cosmopotamian/HadesFCS/Hardware/Hades/Hades.kicad_pcb

## KiCad design Hardware/Hades/Hades.kicad_pcb (2025-03-08)

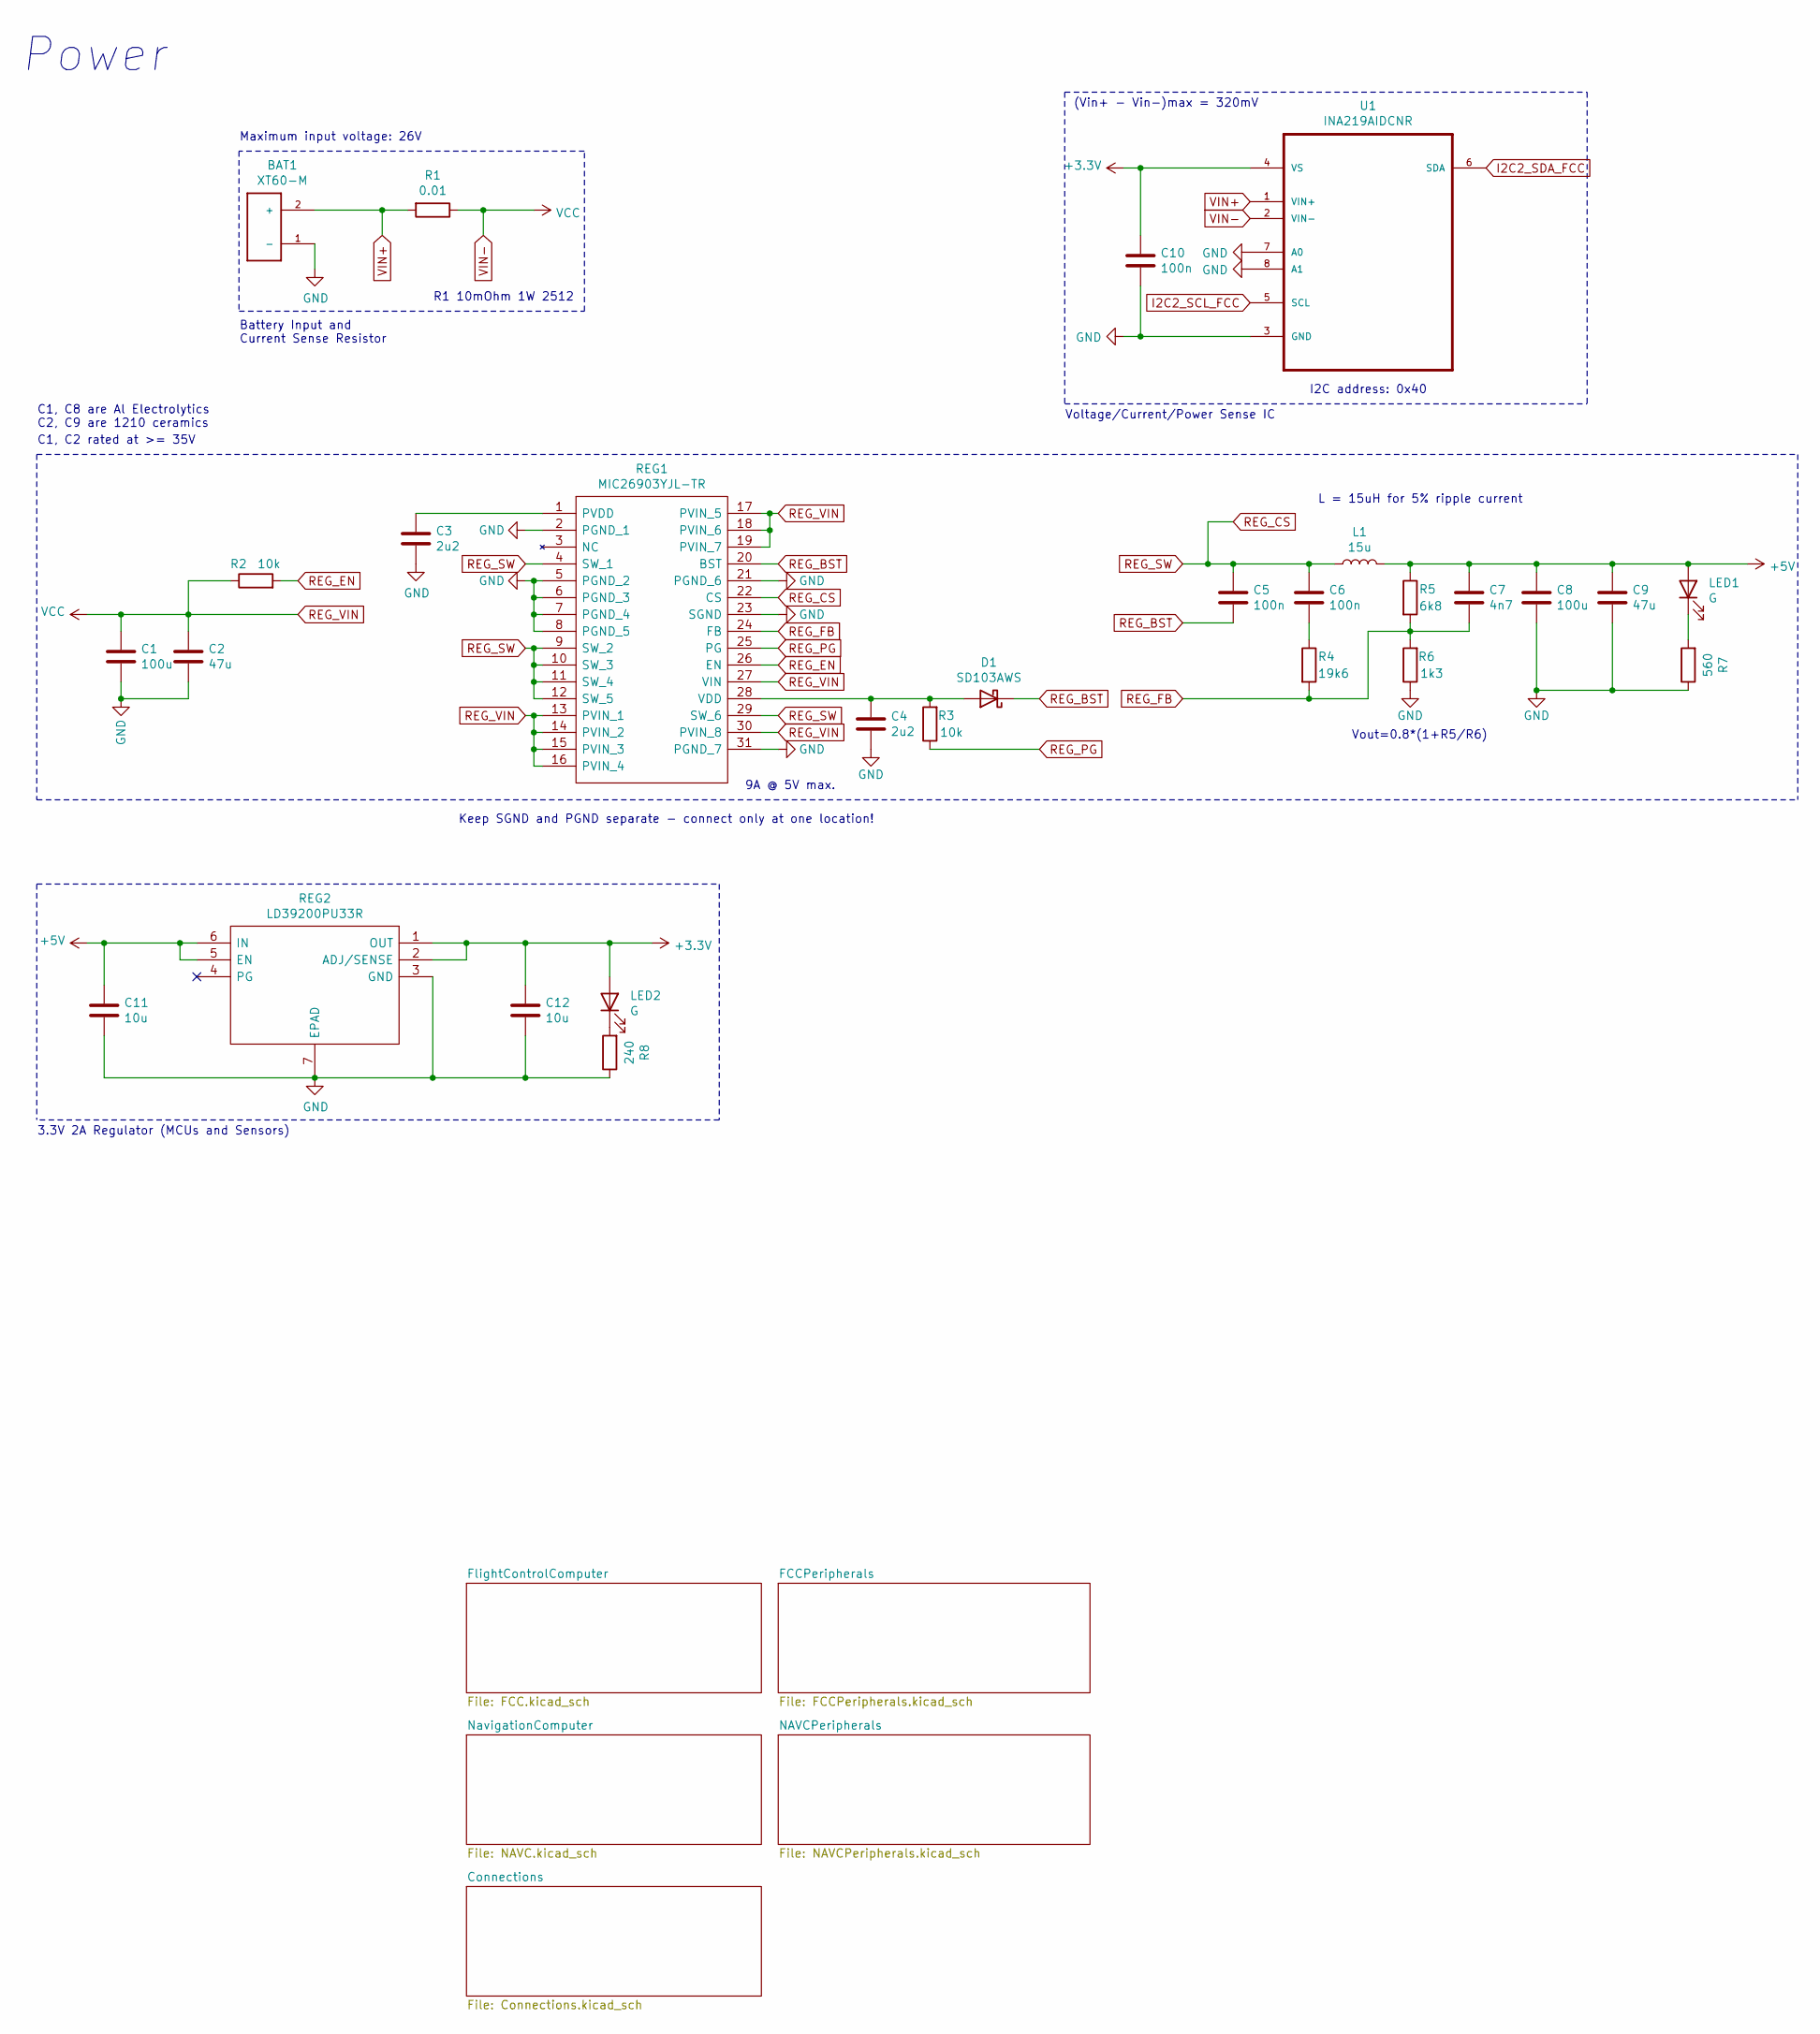
[picture p1: schematic Hades.kicad_sch, Power]

Parts:
BAT1: XT60-M; AMASS_XT60-M
C1, C8: 100u; C_Elec_6.3x7.7
C2, C9: 47u; C_1210_3225Metric
C3, C4: 2u2; C_0805_2012Metric
C5, C6: 100n; C_0805_2012Metric
C7: 4n7; C_0805_2012Metric
C10: 100n; C_0402_1005Metric
C11, C12: 10u; C_0603_1608Metric
D1: SD103AWS; D_SOD-323
L1: 15u; INDPM135125X650N
LED1, LED2: G; LED_0603_1608Metric
R1: 0.01; R_2512_6332Metric
R2, R3: 10k; R_0805_2012Metric
R4: 19k6; R_0805_2012Metric
R5: 6k8; R_0805_2012Metric
R6: 1k3; R_0805_2012Metric
R7: 560; R_0603_1608Metric
R8: 240; R_0603_1608Metric
REG1: MIC26903YJL-TR; MIC24054YJLTR; Manufacturer_Part_Number MIC26903YJL-TR; Mouser Part Number 998-MIC26903YJLTR
REG2: LD39200PU33R; SON95P300X300X100-7N-D; Manufacturer_Part_Number LD39200PU33R; Mouser Part Number 511-LD39200PU33R
U1: INA219AIDCNR; SOT65P280X145-8N

Connections:
+5V: C7.1, C8.1, C9.1, C11.1, L1.2, LED1.2 (A), R5.1, REG2.5 (EN), REG2.6 (IN); also elsewhere on the board
GND: BAT1.1 (-), C1.2, C2.2, C3.2, C4.2, C8.2, C9.2, C10.2, C11.2, C12.2, R6.1, R7.1, R8.1, REG1.2 (PGND_1), REG1.5 (PGND_2), REG1.6 (PGND_3), REG1.7 (PGND_4), REG1.8 (PGND_5), REG1.21 (PGND_6), REG1.23 (SGND), REG1.31 (PGND_7), REG2.3 (GND), REG2.7 (EPAD), U1.3 (GND), U1.7 (A0), U1.8 (A1); also elsewhere on the board
I2C2_SCL_FCC: U1.5 (SCL); also elsewhere on the board
I2C2_SDA_FCC: U1.6 (SDA); also elsewhere on the board
unnamed: C3.1, REG1.1 (PVDD)
unnamed: C4.1, D1.2 (A), R3.2, REG1.28 (VDD)
unnamed: C6.2, R4.1
unnamed: LED1.1 (K), R7.2
unnamed: LED2.1 (K), R8.2
REG_BST: C5.2, D1.1 (K), REG1.20 (BST)
REG_CS: C5.1, C6.1, L1.1, REG1.4 (SW_1), REG1.9 (SW_2), REG1.10 (SW_3), REG1.11 (SW_4), REG1.12 (SW_5), REG1.22 (CS), REG1.29 (SW_6)
REG_EN: R2.2, REG1.26 (EN)
REG_FB: C7.2, R4.2, R5.2, R6.2, REG1.24 (FB)
REG_PG: R3.1, REG1.25 (PG)
REG_VIN: C1.1, C2.1, R1.1, R2.1, REG1.13 (PVIN_1), REG1.14 (PVIN_2), REG1.15 (PVIN_3), REG1.16 (PVIN_4), REG1.17 (PVIN_5), REG1.18 (PVIN_6), REG1.19 (PVIN_7), REG1.27 (VIN), REG1.30 (PVIN_8), U1.2 (VIN-)
VIN+: BAT1.2 (+), R1.2, U1.1 (VIN+)

Notes on the sheet:
Voltage/Current/Power Sense IC
Power
C1, C8 are Al Electrolytics C2, C9 are 1210 ceramics
C1, C2 rated at >= 35V
(Vin+ - Vin-)max = 320mV
R1 10mOhm 1W 2512
3.3V 2A Regulator (MCUs and Sensors)
9A @ 5V max.
Vout=0.8*(1+R5/R6)
L = 15uH for 5% ripple current
Keep SGND and PGND separate - connect only at one location!
I2C address: 0x40
Maximum input voltage: 26V
Battery Input and Current Sense Resistor

Schematic: FCC.kicad_sch, Flight Control Computer

Parts:
C13, C14: 2u2; C_0603_1608Metric
C15: 10u; C_0603_1608Metric
C16, C17, C18, C19, C20, C21, C22, C23, C24, C25, C26, C28, C30, C31: 100n; C_0402_1005Metric
C27, C29: 1u; C_0603_1608Metric
C32, C33: 10p; C_0402_1005Metric
FB1: Ferrite_Bead_Small; L_0402_1005Metric
FCC1: STM32H753VITx; LQFP-100_14x14mm_P0.5mm
HSE1: 25MHz; Crystal_SMD_Abracon_ABM8G-4Pin_3.2x2.5mm
LED3, LED4: R; LED_0603_1608Metric
LED5: Y; LED_0603_1608Metric
LED6, LED7, LED8: B; LED_0603_1608Metric
R9, R10, R11, R12, R13, R14: 4k7; R_0402_1005Metric
R15, R16, R17: 330; R_0603_1608Metric
R18, R19, R20: 100; R_0603_1608Metric
R21: 47; R_0402_1005Metric
R22: 10k; R_0402_1005Metric
R23: 620; R_0603_1608Metric
SW1: SKRPANE010; SKRPADE010; Manufacturer_Part_Number SKRPANE010; Mouser Part Number 688-SKRPANE010
SW2: TDD01H0SB1R; SOT175P420X230-3N; Manufacturer_Part_Number TDD01H0SB1R; Mouser Part Number 611-TDD01H0SB1R
TP1, TP2: I2C1; TestPoint_Pad_D1.5mm

Connections:
BOOT0_FCC: R22.2; also elsewhere on the board
GND: C13.2, C14.2, C15.2, C16.2, C17.2, C18.2, C19.2, C20.2, C21.2, C22.2, C23.2, C24.2, C25.2, C26.2, C27.2, C28.2, C29.2, C30.2, C31.2, C32.2, C33.2, FCC1.10 (VSS), FCC1.19 (VSSA), FCC1.26 (VSS), FCC1.49 (VSS), FCC1.74 (VSS), FCC1.99 (VSS), HSE1.2, HSE1.4, R15.1, R16.1, R17.1, R18.1, R19.1, R20.1, SW1.3, SW1.4, SW2.2; also elsewhere on the board
HSE_IN_FCC: C32.1, FCC1.5 (PE6), HSE1.1; also elsewhere on the board
HSE_OUT_FCC: FCC1.37 (PE7), R23.1; also elsewhere on the board
I2C1_SCL_FCC: FCC1.93 (PB7), R9.2, TP1.1; also elsewhere on the board
I2C1_SDA_FCC: FCC1.95 (PB8), R10.2, TP2.1; also elsewhere on the board
I2C2_SCL_FCC: FCC1.47 (PB11), R11.2; also elsewhere on the board
I2C2_SDA_FCC: FCC1.51 (PB12), R12.2; also elsewhere on the board
I2C3_SCL_FCC: FCC1.68 (PA9), R13.2; also elsewhere on the board
I2C3_SDA_FCC: FCC1.78 (PC10), R14.2; also elsewhere on the board
LED_A_FCC: FCC1.35 (PB1), LED3.2 (A); also elsewhere on the board
LED_B_FCC: FCC1.36 (PB2), LED4.2 (A); also elsewhere on the board
LED_C_FCC: FCC1.89 (PB3), LED5.2 (A); also elsewhere on the board
LED_D_FCC: FCC1.90 (PB4), LED6.2 (A); also elsewhere on the board
LED_E_FCC: FCC1.91 (PB5), LED7.2 (A); also elsewhere on the board
LED_F_FCC: FCC1.92 (PB6), LED8.2 (A); also elsewhere on the board
NRST_FCC: C31.1, SW1.1, SW1.2; also elsewhere on the board
unnamed 65: C13.1; also elsewhere on the board
unnamed 66: C14.1, FCC1.12 (PH0); also elsewhere on the board
unnamed: C33.1, HSE1.3, R23.2
unnamed: LED3.1 (K), R15.2
unnamed: LED4.1 (K), R16.2
unnamed: LED5.1 (K), R17.2
unnamed: LED6.1 (K), R18.2
unnamed: LED7.1 (K), R19.2
unnamed: LED8.1 (K), R20.2
unnamed: R22.1, SW2.3 (C)
VDDA_FCC: C27.1, C28.1, FB1.1, R21.2; also elsewhere on the board
VREF+_FCC: C29.1, C30.1, FCC1.13 (PH1), R21.1; also elsewhere on the board

Notes on the sheet:
Bootmode Switch
C32 = C33 = 2 * (CL - Cstray)
Flight Control Computer (FCC)
High Speed External Crystal
C13, C14: ESR < 100mOhm
AN2606 (Bootloaders): USART1 Bootloader (PB14/PB15)
STM32H7: see AN4938
ABM8G-25.000MHZ-4Y-T3
Test Points (I2C2)
UART2, I2C1, and GPIO_A to GPIO_H -> NAVC UART1 -> Debug (via USB) TIM4 -> PWM/PPM input
Not using LSE as do not need RTC
C15, C27, C29 Tantalum
Rext = 1/(2*pi*f*CL2)
TDD01H0SB1R = SPDT
VREF+ Filter
VDDA Filter
Reset Switch
Indicator LEDs
Decoupling Capactors
STM32H7 has internal NRST pull-up resistor (40k)
I2C Pull-Up Resistors
Cstray = {2pF, 5pf}

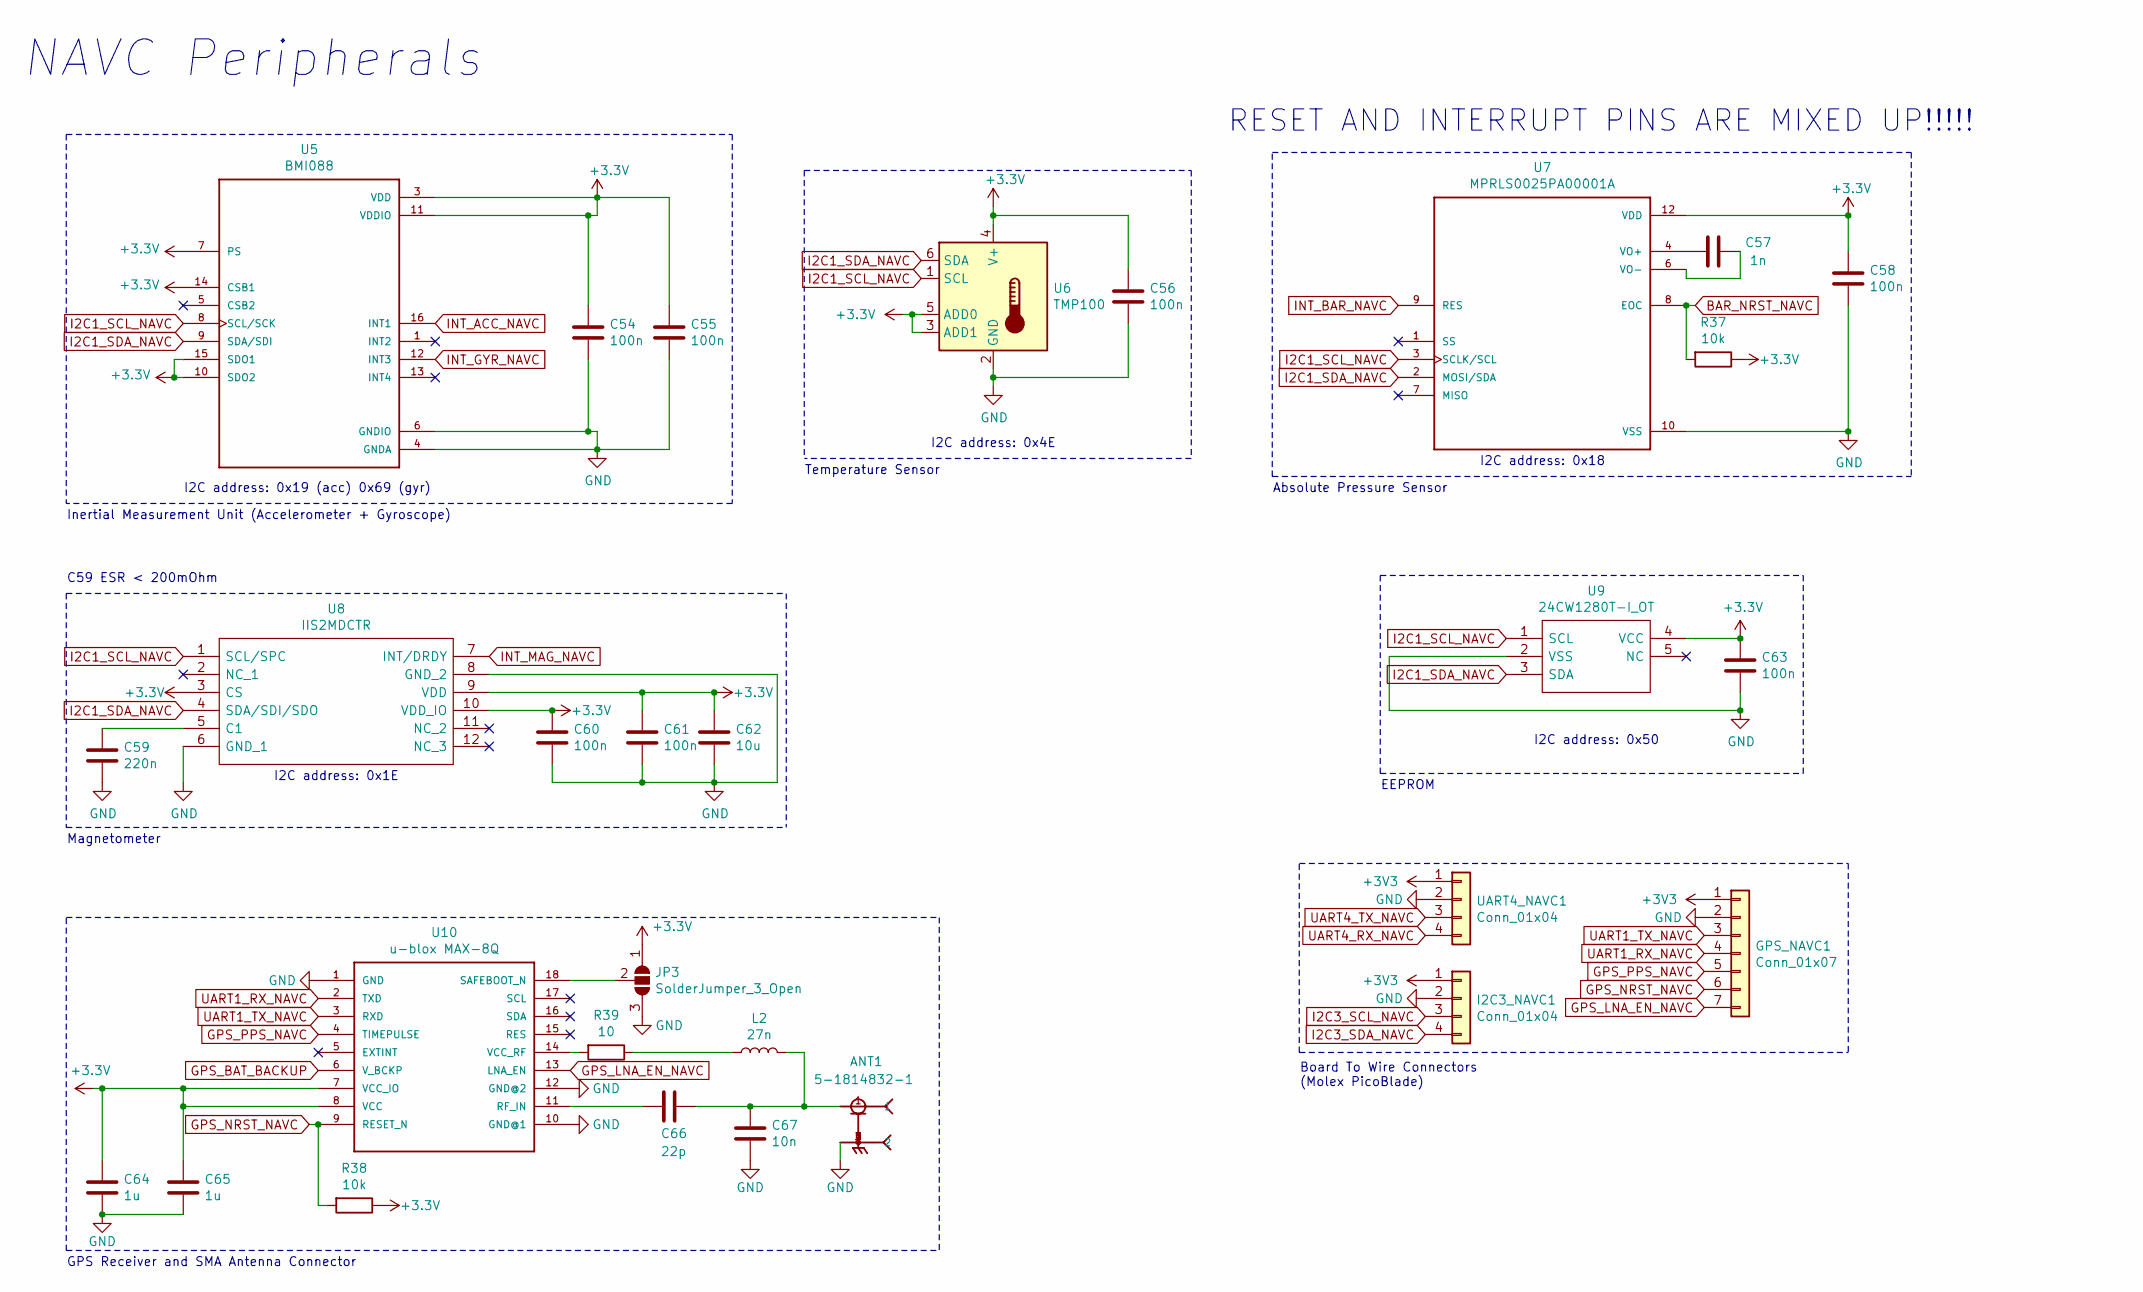
[picture p2: schematic NAVCPeripherals.kicad_sch, NAVC Peripherals]

Parts:
ANT1: 5-1814832-1; TE_5-1814832-1
C54, C55, C56, C58, C60, C61, C63: 100n; C_0402_1005Metric
C57: 1n; C_0402_1005Metric
C59: 220n; C_0603_1608Metric
C62: 10u; C_0603_1608Metric
C64, C65: 1u; C_0603_1608Metric
C66: 22p; C_0402_1005Metric
C67: 10n; C_0402_1005Metric
GPS_NAVC1: Conn_01x07; Molex_PicoBlade_53048-0710_1x07_P1.25mm_Horizontal
I2C3_NAVC1: Conn_01x04; Molex_PicoBlade_53048-0410_1x04_P1.25mm_Horizontal
JP3: SolderJumper_3_Open; SolderJumper-3_P1.3mm_Open_RoundedPad1.0x1.5mm
L2: 27n; L_0402_1005Metric
R37, R38: 10k; R_0402_1005Metric
R39: 10; R_0402_1005Metric
U5: BMI088; PQFN50P450X300X100-16N
U6: TMP100; SOT-23-6
U7: MPRLS0025PA00001A; XDCR_MPRLS0025PA00001A
U8: IIS2MDCTR; Manufacturer_Part_Number IIS2MDCTR; Mouser Part Number 511-IIS2MDCTR
U9: 24CW1280T-I_OT; SOT95P280X145-5N; Manufacturer_Part_Number 24CW1280T-I/OT; Mouser Part Number 579-24CW1280T-I/OT
U10: u-blox MAX-8Q; GPS18P-SMD-1.1-10X9.6MM
UART4_NAVC1: Conn_01x04; Molex_PicoBlade_53048-0410_1x04_P1.25mm_Horizontal

Connections:
BAR_NRST_NAVC: R37.2, U7.8 (EOC); also elsewhere on the board
GND: ANT1.2, ANT1.3 (2), ANT1.4 (2), ANT1.5 (2), C54.2, C55.2, C56.2, C58.2, C59.2, C60.2, C61.2, C62.2, C63.2, C64.2, C65.2, C67.2, GPS_NAVC1.2, I2C3_NAVC1.2, JP3.3 (B), U5.4 (GNDA), U5.6 (GNDIO), U6.2 (GND), U7.10 (VSS), U8.6 (GND_1), U8.8 (GND_2), U9.2 (VSS), U10.1 (GND), U10.10 (GND@1), U10.12 (GND@2), UART4_NAVC1.2; also elsewhere on the board
GPS_BAT_BACKUP: U10.6 (V_BCKP); also elsewhere on the board
GPS_LNA_EN_NAVC: GPS_NAVC1.7, U10.13 (LNA_EN); also elsewhere on the board
GPS_NRST_NAVC: GPS_NAVC1.6, R38.2, U10.9 (RESET_N); also elsewhere on the board
GPS_PPS_NAVC: GPS_NAVC1.5, U10.4 (TIMEPULSE); also elsewhere on the board
I2C1_SCL_NAVC: U5.8 (SCL/SCK), U6.1 (SCL), U7.3 (SCLK/SCL), U8.1 (SCL/SPC), U9.1 (SCL); also elsewhere on the board
I2C1_SDA_NAVC: U5.9 (SDA/SDI), U6.6 (SDA), U7.2 (MOSI/SDA), U8.4 (SDA/SDI/SDO), U9.3 (SDA); also elsewhere on the board
INT_ACC_NAVC: U5.16 (INT1); also elsewhere on the board
INT_BAR_NAVC: U7.9 (RES); also elsewhere on the board
INT_GYR_NAVC: U5.12 (INT3); also elsewhere on the board
INT_MAG_NAVC: U8.7 (INT/DRDY); also elsewhere on the board
unnamed: ANT1.1, C66.1, C67.1, L2.2
unnamed: C57.1, U7.6 (VO-)
unnamed: C57.2, U7.4 (VO+)
unnamed: C59.1, U8.5 (C1)
unnamed: C66.2, U10.11 (RF_IN)
unnamed: GPS_NAVC1.1, I2C3_NAVC1.1, UART4_NAVC1.1
unnamed: JP3.2 (C), U10.18 (SAFEBOOT_N)
unnamed: L2.1, R39.1
unnamed: R39.2, U10.14 (VCC_RF)
UART1_RX_NAVC: GPS_NAVC1.4, U10.2 (TXD); also elsewhere on the board
UART1_TX_NAVC: GPS_NAVC1.3, U10.3 (RXD); also elsewhere on the board

Notes on the sheet:
Board To Wire Connectors (Molex PicoBlade)
Inertial Measurement Unit (Accelerometer + Gyroscope)
C59 ESR < 200mOhm
I2C address: 0x1E
NAVC Peripherals
I2C address: 0x18
EEPROM
Temperature Sensor
I2C address: 0x19 (acc) 0x69 (gyr)
GPS Receiver and SMA Antenna Connector
I2C address: 0x4E
RESET AND INTERRUPT PINS ARE MIXED UP!!!!!
Magnetometer
Absolute Pressure Sensor
I2C address: 0x50

Schematic: Connections.kicad_sch

Parts:
C68, C69, C70, C71: 100n; C_0402_1005Metric
D2, D3, D4, D5: SD103AWS; D_SOD-323
FB3, FB4, FB5, FB6: Ferrite_Bead_Small; L_0402_1005Metric
GPS_BAT1: Conn_01x02; Molex_PicoBlade_53048-0210_1x02_P1.25mm_Horizontal
JP1, JP2: SolderJumper_2_Open; SolderJumper-2_P1.3mm_Open_RoundedPad1.0x1.5mm
JP4: Jumper_3_Open; SolderJumper-3_P1.3mm_Open_RoundedPad1.0x1.5mm
LED13, LED14: G; LED_0603_1608Metric
R40, R41, R42, R43, R44, R45, R46, R47, R48, R49: 10; R_0402_1005Metric
R50, R51: 0; R_0603_1608Metric
R52, R53, R55, R56: 22; R_0402_1005Metric
R54, R57: 560; R_0402_1005Metric
R58, R59: 560; R_0603_1608Metric
SWD1, SWD2: Conn_02x05_Odd_Even; PinHeader_2x05_P1.27mm_Vertical_SMD
U11, U12: otter:CH330; SSOP-8_3.9x5.05mm_P1.27mm
USB1, USB2, USB3, USB4: USB_B_Micro; USB_Micro-B_Wuerth_629105150521_CircularHoles

Connections:
+5V: FB3.1, FB4.1, FB5.1, FB6.1; also elsewhere on the board
GND: C68.1, C69.1, C70.1, C71.1, GPS_BAT1.2, R58.1, R59.1, SWD1.3, SWD1.5, SWD1.9, SWD2.3, SWD2.5, SWD2.9, U11.3, U12.3, USB1.5 (GND), USB1.6 (Shield), USB2.5 (GND), USB2.6 (Shield), USB3.5 (GND), USB3.6 (Shield), USB4.5 (GND), USB4.6 (Shield); also elsewhere on the board
GPIO_A_FCC: R40.2; also elsewhere on the board
GPIO_A_NAVC: R40.1; also elsewhere on the board
GPIO_B_FCC: R41.2; also elsewhere on the board
GPIO_B_NAVC: R41.1; also elsewhere on the board
GPIO_C_FCC: R42.2; also elsewhere on the board
GPIO_C_NAVC: R42.1; also elsewhere on the board
GPIO_D_FCC: R43.2; also elsewhere on the board
GPIO_D_NAVC: R43.1; also elsewhere on the board
GPIO_E_FCC: R44.2; also elsewhere on the board
GPIO_E_NAVC: R44.1; also elsewhere on the board
GPIO_F_FCC: R45.2; also elsewhere on the board
GPIO_F_NAVC: R45.1; also elsewhere on the board
GPIO_G_FCC: R46.2; also elsewhere on the board
GPIO_G_NAVC: R46.1; also elsewhere on the board
GPIO_H_FCC: R47.2; also elsewhere on the board
GPIO_H_NAVC: R47.1; also elsewhere on the board
GPS_BAT_BACKUP: JP4.2 (C); also elsewhere on the board
I2C1_SCL_FCC: R50.2; also elsewhere on the board
I2C1_SDA_FCC: R51.2; also elsewhere on the board
I2C2_SCL_NAVC: R50.1; also elsewhere on the board
I2C2_SDA_NAVC: R51.1; also elsewhere on the board
unnamed: C68.2, D4.2 (A), LED13.2 (A), U11.5, USB3.1 (VBUS)
unnamed: C69.2, U11.8
unnamed: C70.2, D5.2 (A), LED14.2 (A), U12.5, USB4.1 (VBUS)
unnamed: C71.2, U12.8
unnamed: D2.1 (K), FB3.2
unnamed: D2.2 (A), JP1.1 (A), USB1.1 (VBUS)
unnamed: D3.1 (K), FB4.2
unnamed: D3.2 (A), JP2.1 (A), USB2.1 (VBUS)
unnamed: D4.1 (K), FB5.2
unnamed: D5.1 (K), FB6.2
unnamed 119: GPS_BAT1.1, JP4.3 (B); also elsewhere on the board
unnamed: LED13.1 (K), R58.2
unnamed: LED14.1 (K), R59.2
unnamed: R52.2, USB1.3 (D+)
unnamed: R53.2, USB1.2 (D-)
unnamed: R54.2, USB1.4 (ID)
unnamed: R55.2, USB2.3 (D+)
unnamed: R56.2, USB2.2 (D-)
unnamed: R57.2, USB2.4 (ID)
unnamed: SWD1.1, SWD2.1
unnamed: U11.1, USB3.3 (D+)
unnamed: U11.2, USB3.2 (D-)
unnamed: U12.1, USB4.3 (D+)
unnamed: U12.2, USB4.2 (D-)
UART1_RX_FCC: U11.6; also elsewhere on the board
UART1_TX_FCC: U11.7; also elsewhere on the board
UART2_RX_FCC: R48.2; also elsewhere on the board
UART2_RX_NAVC: R49.1; also elsewhere on the board
UART2_TX_FCC: R49.2; also elsewhere on the board
UART2_TX_NAVC: R48.1; also elsewhere on the board
UART3_RX_NAVC: U12.6; also elsewhere on the board
UART3_TX_NAVC: U12.7; also elsewhere on the board
USB_DM_FCC: R53.1; also elsewhere on the board
USB_DM_NAVC: R56.1; also elsewhere on the board
USB_DP_FCC: R52.1; also elsewhere on the board
USB_DP_NAVC: R55.1; also elsewhere on the board
USB_ID_FCC: R54.1; also elsewhere on the board
USB_ID_NAVC: R57.1; also elsewhere on the board
USB_VBUS_FCC: JP1.2 (B); also elsewhere on the board
USB_VBUS_NAVC: JP2.2 (B); also elsewhere on the board

Notes on the sheet:
GPS Backup Battery Jumper and Connector
Serial Wire Debug
Connectors (Programming & Debug)
USB Debug
GPS Backup Battery
CH330 UART to USB Converters
USB Programming
GPIO Connections
UART Connections
I2C Connections
Connector: M50-3600542R
Connections (FCC <-> NAVC)

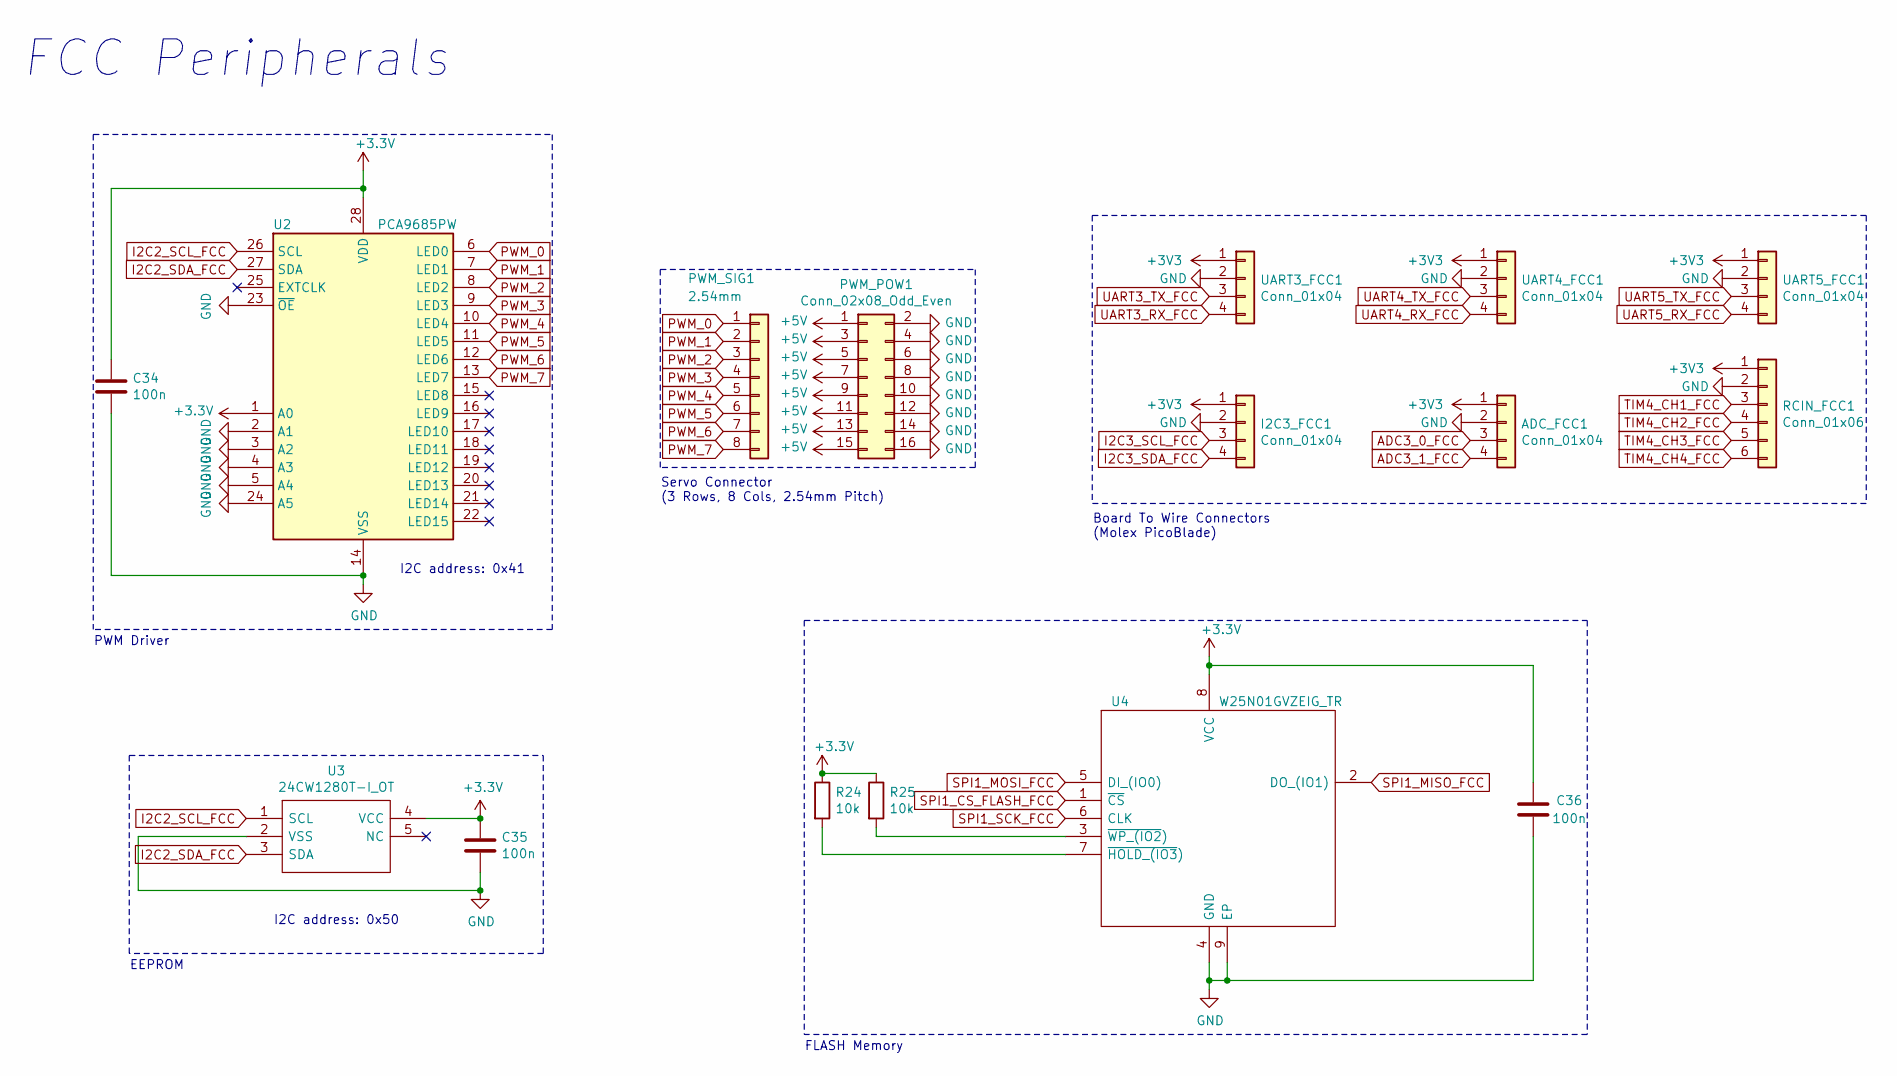
[picture p3: schematic FCCPeripherals.kicad_sch, FCC Peripherals]

Parts:
ADC_FCC1: Conn_01x04; Molex_PicoBlade_53048-0410_1x04_P1.25mm_Horizontal
C34, C35, C36: 100n; C_0402_1005Metric
I2C3_FCC1: Conn_01x04; Molex_PicoBlade_53048-0410_1x04_P1.25mm_Horizontal
PWM_POW1: Conn_02x08_Odd_Even; PinHeader_2x08_P2.54mm_Vertical
PWM_SIG1: 2.54mm; PinHeader_1x08_P2.54mm_Vertical
R24, R25: 10k; R_0402_1005Metric
RCIN_FCC1: Conn_01x06; Molex_PicoBlade_53048-0610_1x06_P1.25mm_Horizontal
U2: PCA9685PW; TSSOP-28_4.4x9.7mm_P0.65mm
U3: 24CW1280T-I_OT; SOT95P280X145-5N; Manufacturer_Part_Number 24CW1280T-I/OT; Mouser Part Number 579-24CW1280T-I/OT
U4: W25N01GVZEIG_TR; SON127P800X600X80-9N-D; Manufacturer_Part_Number W25N01GVZEIG TR; Mouser Part Number 454-W25N01GVZEIGTR
UART3_FCC1, UART4_FCC1, UART5_FCC1: Conn_01x04; Molex_PicoBlade_53048-0410_1x04_P1.25mm_Horizontal

Connections:
+5V: PWM_POW1.1, PWM_POW1.3, PWM_POW1.5, PWM_POW1.7, PWM_POW1.9, PWM_POW1.11, PWM_POW1.13, PWM_POW1.15; also elsewhere on the board
GND: ADC_FCC1.2, C34.2, C35.2, C36.1, I2C3_FCC1.2, PWM_POW1.2, PWM_POW1.4, PWM_POW1.6, PWM_POW1.8, PWM_POW1.10, PWM_POW1.12, PWM_POW1.14, PWM_POW1.16, RCIN_FCC1.2, U2.2 (A1), U2.3 (A2), U2.4 (A3), U2.5 (A4), U2.14 (VSS), U2.23 (~OE), U2.24 (A5), U3.2 (VSS), U4.4 (GND), U4.9 (EP), UART3_FCC1.2, UART4_FCC1.2, UART5_FCC1.2; also elsewhere on the board
I2C2_SCL_FCC: U2.26 (SCL), U3.1 (SCL); also elsewhere on the board
I2C2_SDA_FCC: U2.27 (SDA), U3.3 (SDA); also elsewhere on the board
unnamed: ADC_FCC1.1, I2C3_FCC1.1, RCIN_FCC1.1, UART3_FCC1.1, UART4_FCC1.1, UART5_FCC1.1
unnamed: R24.2, U4.7 (~HOLD_(IO3))
unnamed: R25.2, U4.3 (~WP_(IO2))
PWM_0: PWM_SIG1.1, U2.6 (LED0)
PWM_1: PWM_SIG1.2, U2.7 (LED1)
PWM_2: PWM_SIG1.3, U2.8 (LED2)
PWM_3: PWM_SIG1.4, U2.9 (LED3)
PWM_4: PWM_SIG1.5, U2.10 (LED4)
PWM_5: PWM_SIG1.6, U2.11 (LED5)
PWM_6: PWM_SIG1.7, U2.12 (LED6)
PWM_7: PWM_SIG1.8, U2.13 (LED7)
SPI1_CS_FLASH_FCC: U4.1 (~CS); also elsewhere on the board
SPI1_MISO_FCC: U4.2 (DO_(IO1)); also elsewhere on the board
SPI1_MOSI_FCC: U4.5 (DI_(IO0)); also elsewhere on the board
SPI1_SCK_FCC: U4.6 (CLK); also elsewhere on the board

Notes on the sheet:
I2C address: 0x41
EEPROM
FLASH Memory
Board To Wire Connectors (Molex PicoBlade)
Servo Connector (3 Rows, 8 Cols, 2.54mm Pitch)
PWM Driver
FCC Peripherals
I2C address: 0x50

Schematic: NAVC.kicad_sch, Navigation Computer

Parts:
C37, C38: 2u2; C_0603_1608Metric
C39: 10u; C_0603_1608Metric
C40, C41, C42, C43, C44, C45, C46, C47, C48, C49, C51: 100n; C_0402_1005Metric
C50: 1u; C_0603_1608Metric
C52, C53: 10p; C_0402_1005Metric
FB2: Ferrite_Bead_Small; L_0402_1005Metric
HSE2: 25MHz; Crystal_SMD_Abracon_ABM8G-4Pin_3.2x2.5mm
LED9, LED10: R; LED_0603_1608Metric
LED11: Y; LED_0603_1608Metric
LED12: B; LED_0603_1608Metric
NAVC1: STM32F405RGTx; LQFP-64_10x10mm_P0.5mm
R26, R27: 10k; R_0402_1005Metric
R28, R29, R30, R31: 4k7; R_0402_1005Metric
R32: 620; R_0603_1608Metric
R33, R34, R35: 330; R_0603_1608Metric
R36: 100; R_0603_1608Metric
SW3, SW4: TDD01H0SB1R; SOT175P420X230-3N; Manufacturer_Part_Number TDD01H0SB1R; Mouser Part Number 611-TDD01H0SB1R
SW5: SKRPANE010; SKRPADE010; Manufacturer_Part_Number SKRPANE010; Mouser Part Number 688-SKRPANE010
TP3, TP4: I2C1; TestPoint_Pad_D1.5mm

Connections:
BOOT0_NAVC: R26.2; also elsewhere on the board
BOOT1_NAVC: R27.2; also elsewhere on the board
GND: C37.2, C38.2, C39.2, C40.2, C41.2, C42.2, C43.2, C44.2, C45.2, C46.2, C47.2, C48.2, C49.2, C50.2, C51.2, C52.2, C53.2, HSE2.2, HSE2.4, R33.1, R34.1, R35.1, R36.1, SW3.2, SW4.2, SW5.3, SW5.4; also elsewhere on the board
HSE_IN_NAVC: C52.1, HSE2.1; also elsewhere on the board
HSE_OUT_NAVC: R32.1; also elsewhere on the board
I2C1_SCL_NAVC: R28.2, TP3.1; also elsewhere on the board
I2C1_SDA_NAVC: R29.2, TP4.1; also elsewhere on the board
I2C3_SCL_NAVC: R30.2; also elsewhere on the board
I2C3_SDA_NAVC: R31.2; also elsewhere on the board
LED_A_NAVC: LED9.2 (A); also elsewhere on the board
LED_B_NAVC: LED10.2 (A); also elsewhere on the board
LED_C_NAVC: LED11.2 (A); also elsewhere on the board
LED_D_NAVC: LED12.2 (A); also elsewhere on the board
NRST_NAVC: C49.1, SW5.1, SW5.2; also elsewhere on the board
unnamed 68: C37.1, NAVC1.5 (PH0); also elsewhere on the board
unnamed 69: C38.1, NAVC1.6 (PH1); also elsewhere on the board
unnamed: C53.1, HSE2.3, R32.2
unnamed: LED9.1 (K), R33.2
unnamed: LED10.1 (K), R34.2
unnamed: LED11.1 (K), R35.2
unnamed: LED12.1 (K), R36.2
unnamed: NAVC1.18 (VSS), NAVC1.63 (VSS)
unnamed: R26.1, SW3.3 (C)
unnamed: R27.1, SW4.3 (C)
VDDA_NAVC: C50.1, C51.1, FB2.1, NAVC1.13 (VDDA); also elsewhere on the board

Notes on the sheet:
Cstray = {2pF, 5pf}
UART2, I2C2, and GPIO_A to GPIO_H -> FCC UART3 -> Debug (via USB)
Indicator LEDs
I2C Pull-Up Resistors
C39, C50 Tantalum
Rext = 1/(2*pi*f*CL2)
C52 = C53 = 2 * (CL - Cstray)
ABM8G-25.000MHZ-4Y-T3
Reset Switch
High Speed External Crystal
Decoupling Capactors
Navigation Computer (NAVC)
VDDA Filter
C37, C38: ESR < 100mOhm
STM32F4 has internal NRST pull-up resistor (40k)
I2C2_NAVC already pulled up by I2C1_FCC resistors!
AN2606 (Bootloaders): USART3 Bootloader PC10/PC11
Test Points (I2C1)
Bootmode Switches

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
