cosmopotamian/HadesFCS/Hardware/Hades/Hades.kicad_pcb

## KiCad design Hardware/Hades/Hades.kicad_pcb (continued)

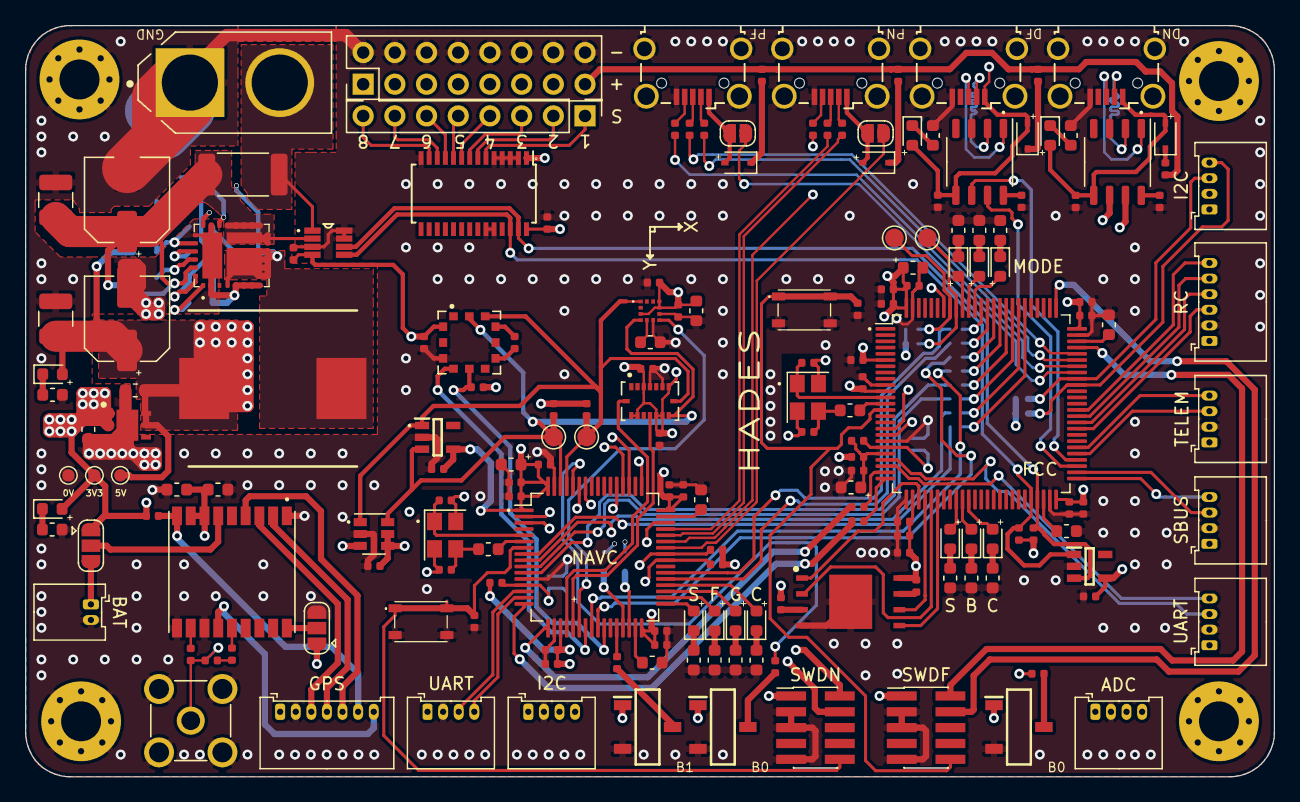
[picture p4: board Hades.kicad_pcb from above]

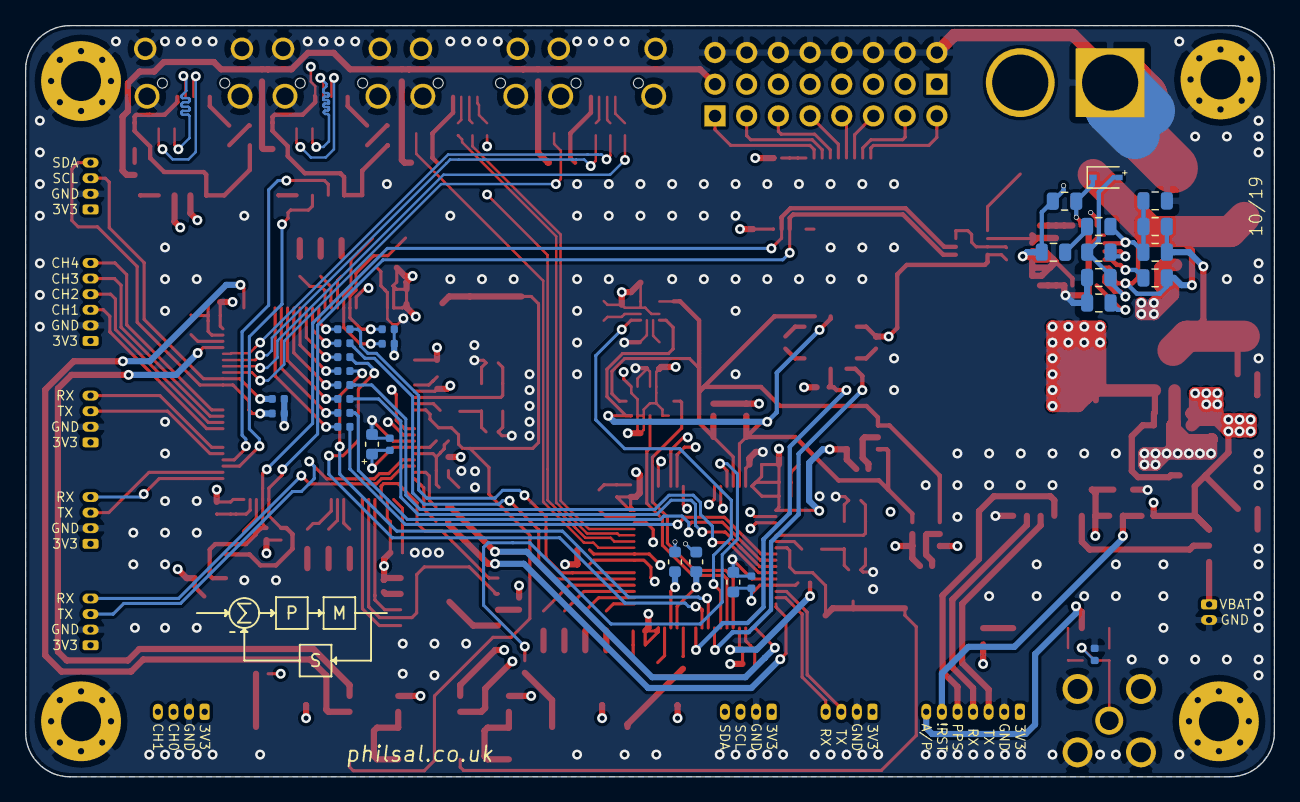
[picture p5: board Hades.kicad_pcb from below]

Board: 4 copper layers, 100.1 x 60.2 mm, 211 parts (30 on the bottom side), 174 nets.

Other parts of the board:
5V, 5V#2, 5V#3: TestPoint_Pad_D1.0mm
ADC: Conn_01x04; Molex_PicoBlade_53048-0410_1x04_P1.25mm_Horizontal
BAT: Conn_01x02; Molex_PicoBlade_53048-0210_1x02_P1.25mm_Horizontal
FCC: STM32H753VITx; LQFP-100_14x14mm_P0.5mm
GPS: Conn_01x07; Molex_PicoBlade_53048-0710_1x07_P1.25mm_Horizontal
I2C, I2C#2: Conn_01x04; Molex_PicoBlade_53048-0410_1x04_P1.25mm_Horizontal
NAVC: STM32F405RGTx; LQFP-64_10x10mm_P0.5mm
RC: Conn_01x06; Molex_PicoBlade_53048-0610_1x06_P1.25mm_Horizontal
SBUS: Conn_01x04; Molex_PicoBlade_53048-0410_1x04_P1.25mm_Horizontal
SWDF: Conn_02x05_Odd_Even; PinHeader_2x05_P1.27mm_Vertical_SMD
SWDN: Conn_02x05_Odd_Even; PinHeader_2x05_P1.27mm_Vertical_SMD
TELEM: Conn_01x04; Molex_PicoBlade_53048-0410_1x04_P1.25mm_Horizontal
UART: Conn_01x04; Molex_PicoBlade_53048-0410_1x04_P1.25mm_Horizontal
UART#2: Conn_01x04; Molex_PicoBlade_53048-0410_1x04_P1.25mm_Horizontal

Their connections:
+5V: 5V.1; also elsewhere on the board
ADC3_0_FCC: ADC.3, FCC.17
ADC3_1_FCC: ADC.4, FCC.18
BAR_NRST_NAVC: NAVC.26; also elsewhere on the board
BOOT0_FCC: FCC.94; also elsewhere on the board
BOOT0_NAVC: NAVC.60; also elsewhere on the board
BOOT1_NAVC: NAVC.28; also elsewhere on the board
GND: 5V#3.1, ADC.2, BAT.2, FCC.10, FCC.19, FCC.26, FCC.49, FCC.74, FCC.99, GPS.2, I2C.2, I2C#2.2, NAVC.12, NAVC.18, NAVC.63, RC.2, SBUS.2, SWDF.3, SWDF.5, SWDF.9, SWDN.3, SWDN.5, SWDN.9, TELEM.2, UART.2, UART#2.2; also elsewhere on the board
GPIO_A_FCC: FCC.81; also elsewhere on the board
GPIO_A_NAVC: NAVC.8; also elsewhere on the board
GPIO_B_FCC: FCC.82; also elsewhere on the board
GPIO_B_NAVC: NAVC.9; also elsewhere on the board
GPIO_C_FCC: FCC.83; also elsewhere on the board
GPIO_C_NAVC: NAVC.10; also elsewhere on the board
GPIO_D_FCC: FCC.84; also elsewhere on the board
GPIO_D_NAVC: NAVC.11; also elsewhere on the board
GPIO_E_FCC: FCC.85; also elsewhere on the board
GPIO_E_NAVC: NAVC.24; also elsewhere on the board
GPIO_F_FCC: FCC.86; also elsewhere on the board
GPIO_F_NAVC: NAVC.25; also elsewhere on the board
GPIO_G_FCC: FCC.87; also elsewhere on the board
GPIO_G_NAVC: NAVC.37; also elsewhere on the board
GPIO_H_FCC: FCC.88; also elsewhere on the board
GPIO_H_NAVC: NAVC.38; also elsewhere on the board
GPS_LNA_EN_NAVC: GPS.7, NAVC.2; also elsewhere on the board
GPS_NRST_NAVC: GPS.6, NAVC.3; also elsewhere on the board
GPS_PPS_NAVC: GPS.5, NAVC.53; also elsewhere on the board
HSE_IN_FCC: FCC.12; also elsewhere on the board
HSE_IN_NAVC: NAVC.5; also elsewhere on the board
HSE_OUT_FCC: FCC.13; also elsewhere on the board
HSE_OUT_NAVC: NAVC.6; also elsewhere on the board
I2C1_SCL_FCC: FCC.92; also elsewhere on the board
I2C1_SCL_NAVC: NAVC.61; also elsewhere on the board
I2C1_SDA_FCC: FCC.93; also elsewhere on the board
I2C1_SDA_NAVC: NAVC.62; also elsewhere on the board
I2C2_SCL_FCC: FCC.46; also elsewhere on the board
I2C2_SCL_NAVC: NAVC.29; also elsewhere on the board
I2C2_SDA_FCC: FCC.47; also elsewhere on the board
I2C2_SDA_NAVC: NAVC.30; also elsewhere on the board
I2C3_SCL_FCC: FCC.67, I2C.3; also elsewhere on the board
I2C3_SCL_NAVC: I2C#2.3, NAVC.41; also elsewhere on the board
I2C3_SDA_FCC: FCC.66, I2C.4; also elsewhere on the board
I2C3_SDA_NAVC: I2C#2.4, NAVC.40; also elsewhere on the board
INT_ACC_NAVC: NAVC.20; also elsewhere on the board
INT_BAR_NAVC: NAVC.23; also elsewhere on the board
INT_GYR_NAVC: NAVC.21; also elsewhere on the board
INT_MAG_NAVC: NAVC.22; also elsewhere on the board
LED_A_FCC: FCC.34; also elsewhere on the board
LED_A_NAVC: NAVC.33; also elsewhere on the board
LED_B_FCC: FCC.35; also elsewhere on the board
LED_B_NAVC: NAVC.34; also elsewhere on the board
LED_C_FCC: FCC.36; also elsewhere on the board
LED_C_NAVC: NAVC.35; also elsewhere on the board
LED_D_FCC: FCC.89; also elsewhere on the board
LED_D_NAVC: NAVC.36; also elsewhere on the board
LED_E_FCC: FCC.90; also elsewhere on the board
LED_F_FCC: FCC.91; also elsewhere on the board
NRST_FCC: FCC.14, SWDF.10; also elsewhere on the board
NRST_NAVC: NAVC.7, SWDN.10; also elsewhere on the board
unnamed 65: FCC.48; also elsewhere on the board
unnamed 66: FCC.73; also elsewhere on the board
unnamed 68: NAVC.31; also elsewhere on the board
unnamed 69: NAVC.47; also elsewhere on the board
unnamed 119: BAT.1; also elsewhere on the board
SPI1_CS_FLASH_FCC: FCC.28; also elsewhere on the board
SPI1_MISO_FCC: FCC.30; also elsewhere on the board
SPI1_MOSI_FCC: FCC.31; also elsewhere on the board
SPI1_SCK_FCC: FCC.29; also elsewhere on the board
SWCLK_FCC: FCC.76, SWDF.4
SWCLK_NAVC: NAVC.49, SWDN.4
SWDIO_FCC: FCC.72, SWDF.2
SWDIO_NAVC: NAVC.46, SWDN.2
TIM4_CH1_FCC: FCC.59, RC.3
TIM4_CH2_FCC: FCC.60, RC.4
TIM4_CH3_FCC: FCC.61, RC.5
TIM4_CH4_FCC: FCC.62, RC.6
UART1_RX_FCC: FCC.54; also elsewhere on the board
UART1_RX_NAVC: GPS.4, NAVC.59; also elsewhere on the board
UART1_TX_FCC: FCC.53; also elsewhere on the board
UART1_TX_NAVC: GPS.3, NAVC.58; also elsewhere on the board
UART2_RX_FCC: FCC.25; also elsewhere on the board
UART2_RX_NAVC: NAVC.17; also elsewhere on the board
UART2_TX_FCC: FCC.24; also elsewhere on the board
UART2_TX_NAVC: NAVC.16; also elsewhere on the board
UART3_RX_FCC: FCC.56, TELEM.4
UART3_RX_NAVC: NAVC.52; also elsewhere on the board
UART3_TX_FCC: FCC.55, TELEM.3
UART3_TX_NAVC: NAVC.51; also elsewhere on the board
UART4_RX_FCC: FCC.23, UART#2.4
UART4_RX_NAVC: NAVC.15, UART.4
UART4_TX_FCC: FCC.22, UART#2.3
UART4_TX_NAVC: NAVC.14, UART.3
UART5_RX_FCC: FCC.51, SBUS.4
UART5_TX_FCC: FCC.52, SBUS.3
USB_DM_FCC: FCC.70; also elsewhere on the board
USB_DM_NAVC: NAVC.44; also elsewhere on the board
USB_DP_FCC: FCC.71; also elsewhere on the board
USB_DP_NAVC: NAVC.45; also elsewhere on the board
USB_ID_FCC: FCC.69; also elsewhere on the board
USB_ID_NAVC: NAVC.43; also elsewhere on the board
USB_VBUS_FCC: FCC.68; also elsewhere on the board
USB_VBUS_NAVC: NAVC.42; also elsewhere on the board
VDDA_FCC: FCC.21; also elsewhere on the board
VDDA_NAVC: NAVC.13; also elsewhere on the board
VREF+_FCC: FCC.20; also elsewhere on the board
